lhn-hub/stm32-smart-environment-monitor/Docs/M3-acceptance.md

# M3传感器驱动与DataHub交付

2026-10-11最新DHT修订：初始化预配置EXTI12、接收使能后显式释放PB12开漏，增加失败电平/IRQ诊断；复测见M3-dht11-fix.md。当前普通固件合入此前M4/Flash修复，Flash54164B/RAM19488B，0错误0警告，实板DHT成功率仍待验证。

超声波修订已获用户确认：PA15=TRIG、PB3=ECHO（EXTI3优先级5），不再使用PA15回波输入。请按M3-ultrasonic-root-cause.md的烧录/复测步骤执行。该次历史构建Flash45484B/RAM16960B；后文最初构建数字为历史基线。

构建日期：2026-10-06。最终Code=40040、RO=3912、RW=112、ZI=16704；Flash44064B、RAM16816B，相比v0.3的39464B/15832B分别增加4600B/984B。距60KB Flash上限剩17376B，距20KB RAM剩3664B；11KB RTOS堆已包含在RAM中，任务栈不重复相加。

## 本次状态
按用户授权，采用M3-defaults.md中的资料默认值，不再要求填写标定作业单。代码、Keil构建及主机仿真完成后交付；没有运行实板50次温度采样或10/30/50cm测距，也没有以网上资料替代这些实验。
雷达为用户确认的Rd-03，EC11已取消，菜单继续PA0切换/PB15确认/PC13返回。MQ DO仍存在5V上拉冲突，正式构建`APP_MQ_DO_ENABLED=0`，需要保持DO与MCU断开。v0.4待硬件问题与验收完成，不提前打tag。

## 接线检查
- DHT11：PB12 DATA、3V3/GND，使用原通用IO3，核对供电/数据上拉均为3.3V；不要将模块高压上拉直接接入PB12。
- CS100A：PA15 TRIG、PB3 ECHO，保留原接口/供电；TIM4为1MHz/每ms回卷的HAL时基，测量使用完整bsp_micros时间戳。
- Rd-03：3V3/GND、OT2→PB5，高有效，3.3V电源需有≥200mA供电能力；PB4为蜂鸣器输出；OT1/RX不接USART3。
- MQ2/MQ135 DO：暂不接PB0/PB14；即使软件禁用也不会隔离实际5V，必须物理断开。日后启用必须先处理电平，不可直接将宏改1后接原5V DO。
- 电机仍不接；USB Device口不接。CH340串口115200、8N1、UTF-8。

## 改动文件与数据契约
- `Drivers_Device/sensor.h/.c`：6项固定注册表与sensor_ops_t；sensor_read读取统一缓存，sensor_ioctl获取诊断/修改气体确认时间，SensorTask用ops.read采集后再次通过sensor_read统一发布。
- `App/datahub.h/.c`：约192B的快照含各实例值、质量、时间戳、辅助值、辅助质量、flags及warmup_remaining_ms。互斥只包围内存复制，不在锁中等待硬件或打印。失败保持上次成功时间戳；快照超过各设备周期×3为STALE，已有FAULT不升级。
- `Drivers_Device/dht11/dht11.h/.c`：20ms开漏低电平启动（任务阻塞让出CPU），PB12/EXTI12有序脉宽捕获，82段响应/数据宽度、40bit解码与累加校验、温湿度×10整数，2100ms周期，5样本滑动均值。通信失败清空均值窗口，连续10次失败FAULT，恢复一帧后重新积累。
- `Drivers_Device/cs100a/cs100a.h/.c`：12us触发，PB3/EXTI3双沿ISR只取时间戳，任务等待30ms超时；5样本中值先作用在us再四舍五入为cm；累计不足5样本STALE，连续5次失败FAULT，成功后自动恢复并重新填中值窗口。
- `Drivers_Device/mq_gas/mq_gas.h/.c`：smoke/air两个实例，200ms扫描、低有效、300秒预热倒计时，预热期输出STALE且报警值0，辅助值保留原始DO。已通过主机模拟验证启用路径；正式固件安全门关闭，FAULT并带DISABLED标志，绝不显示正常空气。烟雾确认3秒、空气确认10秒，解除10秒；阈值菜单确认时间通过DataHub同步，仅RAM有效。
- `Drivers_Device/radar_rd03/radar_rd03.h/.c`：PB5高有效，确认/解除均1秒。开机前1秒为STALE，此后质量GOOD仅表示电平采样与消抖有效，不表示验证了设备在线。带NO_OPEN_WIRE_TEST标志。
- `Drivers_Device/mcu_internal/mcu_internal.h/.c`：M1温度函数/ADC快照注册到同一接口；温度继续FAULT，辅助VDDA为标称估算，保留原ADC采样时间；无新DMA采样超过1秒为STALE，ADC错误/零值FAULT。
- `Middleware/filter/sensor_filter.h/.c`：固定5样本中值/均值、带独立确认/解除时长的二态滤波器；整数，无动态大缓冲。
- `BSP/bsp_controls.c`、`Src/stm32f1xx_it.c`：EXTI3处理PB3超声；共享EXTI15_10先PB12 DHT，再PC13；没有EC11。DHT12仅在接收期间开启，完成后显式关闭IMR，因为F1 HAL_GPIO_Init(INPUT)不会自动关闭已有EXTI。
- `BSP/bsp_analog_rtc.c`：记录ADC DMA时间戳，提供任务原子快照。
- `App/tasks/app_tasks.c`：SensorTask枚举采样/发布/统一日志，原6栈和11KB heap不变；修正监控检查使用旧循环时间可能早于最新心跳而无符号下溢的问题。
- `App/menu/menu.c`：主页显示DHT温湿度、距离、雷达检测及MQ禁用/报警状态；FAULT显示文字而非虚构数值，STALE以标志显示。网络状态仍为后续阶段占位。

## DHT11时序与临界区裁决说明
已授权用资料默认值继续。完整DHT响应是3~5ms，原“整段关中断并且总共<2ms”不能同时满足；本实现无需整段屏蔽中断。
临界区仅用于捕获状态和GPIO/EXTI交接，TIM4优先级4不受BASEPRI遮蔽；ISR只记录当前电平和脉宽，不延时/打印/擦Flash。20ms起始与7ms捕获超时都用vTaskDelay等待，若起始低超过手册30ms则此次失败。
EXTI响应延迟和实际临界区时长需逻辑分析仪验证，代码结构不等于“实测<2ms”。现有全局中断优先级与看门狗保留。超声波触发12us为唯一短忙等，未在临界区执行。

## 串口示例及数值单位
下列仅为格式示例，不是实测：
```
[<tick>][采集任务][信息] 传感器 DHT11 值=260/GOOD 附=550/GOOD 时间=<ms> 标志=0x0 预热=0s
[<tick>][采集任务][信息] 传感器 CS100A 值=30/GOOD 附=-1/FAULT 时间=<ms> 标志=0x0 预热=0s
[<tick>][采集任务][信息] 传感器 MQ2 值=-1/FAULT 附=-1/FAULT 时间=<ms> 标志=0x7 预热=299s
[<tick>][采集任务][信息] 传感器 Rd-03 值=1/GOOD 附=-1/FAULT 时间=<ms> 标志=0x4 预热=0s
[<tick>][采集任务][信息] 采集统计 DHT=<成功>/<尝试> 连败=<次数> 超声失败=<累计> 连败=<次数> 发布失败=<次数>
```
- DHT：主值温度×10，附值湿度×10。CS100A：主值cm，辅助不使用。
- MQ：主值0未报警/1报警；辅助原始DO0/1；禁用时均-1/FAULT。flags1=预热、2=禁用、4=不支持开路诊断、8=估算。
- Rd-03：0无人/1检测到目标。MCU：主温度×10或FAULT；附值VDDA mV并有独立质量，flags8=估算。
- 成功率分子为通过解码校验的采样次数，初始无数据FAULT；不能通过重复打印缓存增加成功次数。

## DoD操作
1. **DHT11**：上电后记录连续50次尝试及成功计数差值，至少48次成功才达到≥95%；与相邻参考温度计在稳定环境对比，25℃条件标称温度±2℃、湿度±5%RH。均值有响应延迟，通信成功率与误差分开记录。
2. **超声波**：平面反射板分别在10/30/50cm放稳，等待至少5次成功读数；每点记录5个中值输出，误差≤±1cm。使用M3-calibration.md表格作为可选记录，不再要求上传回填。它是测试记录，不是驱动工作的前置门槛。
3. **MQ**：当前必须显示DISABLED/FAULT，不能验收酒精/呼气硬件翻转。未来安全电平接入后，等待300秒warmup消失，用DO刺激检查烟雾≥3s、空气≥10s确认和≥10s解除，不能把主机仿真当作硬件测试。
4. **雷达**：进入/离开探测区，OT2持续高/低1s后再切换；静止1分钟观察误触发。出厂雷达内部处理延迟还会叠加在软件1s之上，不能仅根据软件定义真实响应时间。
5. **拔线**：DHT连续10次、超声连续5次失败后FAULT，过程中其它任务心跳/屏幕继续运行，接回自动恢复。不短接电源。DO传感器拔线与合法高电平可能相同，无硬件额外信息就不能可靠判开路，本项目不伪造“所有DO拔线10周期FAULT”。
6. **统一接口**：启动后每5秒看到6个名称及相同质量/时间格式，通过注册表数量6及主机测试验证同一sensor_read；无数据的实例仍枚举但不假报成功测量。
7. **资源**：Docs/M3-build.log、M3-map.txt、M3-tests.log保存构建及主机结果。最终增量见交付回复，实际栈剩余仍按运行日志≥30%检查。

## 主机验证与边界
Docs/test_m3.py直接编译实际驱动与注册表：有效/错校验/异常脉宽、ISR时间戳模拟、超时后返回、10/30/50cm计算与中值、计时回绕、MQ安全门/预热/迟滞/参数修改、Rd-03消抖、MCU旧样本、失败质量与恢复、DataHub互斥失败。MQ启用仅在主机临时预处理覆盖，不改变正式配置。
旧菜单/按键与OLED恢复测试继续回归。全部测试不构成实板精度、成功率或真实热插拔证据。
本阶段没有改引脚以绕过电气冲突，没有关闭看门狗/超时/校验/互斥。MQ硬件接入和二值DO开路诊断无法仅靠固件解决，v0.4尚不创建。
