lhn-hub/stm32-smart-environment-monitor/Docs/M2-acceptance.md

# M2 OLED/EC11/菜单交付

## 用户功能验收确认（2026-10-05）
用户在PA0三键版本交付后回复“功能完整”，据此记录M2功能验收并发布v0.3。基线为ede5857：取消EC11，PA0切换、PB15确认、PC13返回。
编译记录0错误0警告，Flash39464B/RAM15832B。未提供的帧率实测值、插拔录像等不补造；下方历史待验收描述保留为操作参考。工作区未提交的Keil本地保存状态不自动纳入发布。

## 最新方案：三键菜单（替换EC11交互验收）
用户明确取消EC11，使用核心板KEY1=PA0切换菜单。EC11驱动文件仅保留历史源码，已从Keil构建及ISR回调移除；PA11/12改普通输入，USB Device仍禁用。断电拆除EC11，无需新模块。
- PA0单击：主页进入菜单；列表下一项，末项回到首项；阈值编辑时+1。
- PA0长按1.5s：列表上一项，首项回到末项；阈值编辑时-1。
- PB15单击：进入/确认、切换阈值编辑状态。编辑中长按PB15：3秒内增减步进10。
- PC13：返回上一级；Font test先退到Manual Test。
原“旋转20格”验收被用户新方案替代；请改测PA0短按/长按各5次、列表首尾循环、4项阈值增减与限幅、PB15确认和PC13返回。OLED恢复/清晰度/帧率要求保持。
主机三键菜单导航/增减/加速/限幅测试通过，编译0错误0警告。Flash39464B，RAM15832B；实板按键操作待用户验证，未打v0.3。

## 显示清晰度/编码器诊断更新
用户反馈OLED不清晰、EC11接原方案仍无正常操作。已将ASCII替换为专用Adafruit classic5x7点阵加空列(6x8)，8x16使用整数倍纵向扩展；7个中文保留。许可随字模保存。主机预览已检查，真实屏幕清晰度待新版烧录后反馈，若仍有错位/花屏需照片以核对控制器及屏幕规格。
EC11没有擅改引脚或每格边沿数，新增5秒诊断：`编码器诊断：AB=3 中断=80 非法跳变=0`。AB是二位编码：3=两路高，2=A高B低，1=A低B高，0=两路低。慢转时中断次数应增加；累计步数仅在菜单选择或阈值编辑时产生可见操作，主页旋钮不会切页，先PB15进入菜单。
实物检查：A→PA12、B→PA11、公共端C→GND（先确认裸编码器公共端，不把模块VCC误接地）；USB Device口禁接。先记录静止与连续20格后的两组“显示/编码器诊断”日志。中断不变时检查接触与线路；非法跳变多时再查抖动/漏边沿；只出现一半计数时核对实物每格边沿，不直接改变4边沿参数。
本次0错误0警告，Flash40432B/RAM15936B；原OLED恢复、菜单和编码器主机测试通过，EC11实物故障仍未定位。

## 状态与约定
基于v0.2，用户同意按本条页面和默认4阈值实现，不依赖未提供的计划书4.4。
软件/主机验证与物理DoD分开；20格实测、插拔恢复、无闪烁、实际10fps未完成前不打v0.3。
默认温度阈值50℃、入侵距离100cm、烟雾确认3000ms、空气确认10000ms，按格步进1，范围0~100/500/60000/60000。只在RAM保存，复位恢复默认；不会在M2驱动真实报警。

## 手工接线
断电插OLED到原接口：PB6=SCL、PB7=SDA，核对模块供电，地址0x3C。
EC11：PA12=A、PA11=B、3V3/GND，SW不接；PB15确认、PC13返回；USB Device口禁止插线。
保留CH340 115200 UTF-8和SWD，电机/业务传感器保持断开。
I2C启动扫描在SensorTask完成后才交给MenuTask，之后恢复/手动扫描由MenuTask独占，避免同时重配总线。不要从其它任务调用I2C。

## 文件与关键实现
- Drivers_Device/oled_ssd1306/ssd1306.h/.c：静态1024B显存，分页/脏页刷新，32B分块有界发送，失败500ms重试并调用M1九脉冲恢复；裁剪点/线/矩形/反白。
- fonts.h：95个ASCII字符的6x8与8x16表，7个16x16中文“报警布防撤故障”。离线将Windows本机Consolas/SimSun光栅化，不在MCU加载字体文件。Font test页用于实屏检查。
- Drivers_Device/ec11/ec11.h/.c：ISR只采样AB快照、写64槽静态环并发任务通知，任务执行4态转移；满4个合法边沿一格，往返抖动抵消，非法双位跳变重置部分格；溢出计数可见，不声称能补回漏边沿。
- Drivers_Device/oled_ui/oled_ui.h/.c：高亮行、进度条、状态符号；W/M/A/!/P依次表示WiFi/MQTT/布防/报警/预热，反白表示有效，下划线表示无效。网络/报警是未实现占位，预热按150秒计时。
- App/menu/menu.h/.c：enter/exit/render/on_key表、主页→菜单→子页三层栈，阈值RAM编辑。PB15单击进入/确认；长按在编辑时启用3秒10倍步进；PC13返回。显示帧周期80ms，不向OLED发送中间空白帧。
- App/tasks/app_tasks.c、BSP/bsp_controls.c：MenuTask消费编码器与统一键事件，维持原6任务栈/优先级/心跳。

## 操作与DoD
1. **编码器20格**：待主页出现，记录串口“编码器”累计数，连续同方向缓慢转20个机械卡点，差值应为+20或-20，丢失=0；反向20格应回原值。再在每秒约5格速度复测，包含轻微回抖。方向正负由实物A/B相位决定，不能把“20格只计10”归为通过；若每卡点只有2边沿或方向与预期不同，报告实测，不擅自改接线/系数。
2. **菜单可达**：PB15进MENU，依次旋转选择Home/Arm/Thresholds/Manual Test/Network/Event Log/System/About，每个子页PC13回MENU，再PC13回主页。选项超过5行会滚动，高亮保持可见。Arm仅切换RAM布防状态。
3. **阈值编辑**：Thresholds选择项目，PB15进入编辑，旋转一格数值±1，底部进度条变化；长按PB15后3秒内步进±10；再单击退出编辑。PC13返回，不保存到Flash。边界限幅，不能越界回绕。
4. **手动测试**：Manual Test含蜂鸣、红/绿/蓝/关、I2C Scan、舵机/风扇占位、Font test。占位不会启动电机或舵机；Font test显示双ASCII字模与7个中文，PC13退出。RGB仍使用已确认低有效语义。
5. **插拔恢复**：仅在确认模块支持热插拔的条件下，按用户DoD在板不断电时断开/接回OLED；否则断电换接不能证明自动恢复。未连接时心跳持续、失败计数增加；接回后无需复位恢复完整画面，System中fail=0；rec为累计恢复尝试次数，故意不归零，避免抹掉历史诊断。严禁短接电源针脚。
6. **帧率/闪烁**：每5秒串口输出`显示：帧率x10=<值> 耗时=<微秒> 编码器=<累计> 丢失=<次数> 连败=<次数> 恢复=<次数>`。帧率x10≥100代表平均≥10fps；耗时由TIM4 bsp_micros实测覆盖当次发送。观察主页/滚动/数字编辑无可见周期性清屏闪烁。正常全屏I2C理论约25~30ms不等于板上测量，不能填成实测成绩。断线期间帧率为0属预期，重连后至少一个完整统计窗再验收。
7. **System**：显示内部温度FAULT/校准OFF、VDDA标称估计、当前MenuTask栈剩余、I2C失败/恢复计数、刷新耗时、版本；温度FAULT沿用之前裁决，不能改为虚构温度。主页温湿度/烟气/距离/有人状态均明确占位，UTC来自RTC计数，未校时不代表真实时间。

## 软件验证
`Docs/test_m2.py` 编译实际EC11解码函数、完整SSD1306实现和实际菜单，模拟HAL边界：+20/-20、抖动/非法转移、脏页/无修改零传输、断线/重连、所有页面可达/返回、编辑加速/限幅、蜂鸣/RGB调用，渲染所有页面到tmp/m2/preview.png供视觉检查。
这些是主机测试，不替代真实机械旋钮、I2C电气或刷新观感。调用图已知worker最大深度约296B，不代替实际高水位；M2仍需确认MenuTask栈剩余≥30%。
全量Keil构建0错误0警告，日志Docs/M2-build.log，map Docs/M2-map.txt。Flash40284B/RAM15928B；v0.2为31628B/14576B，增量8656B/1352B。距60KB Flash红线余21156B、20KB RAM余4552B；RTOS11KB heap包含在RAM统计中，不重复加任务栈。

## 遗留与里程碑
v0.3待用户实板确认后创建。没有自动伪造插拔、帧率、20格或屏幕截图证据；主机预览会明确标为模拟。MenuTask拥有I2C的前提应在后续多客户端阶段改为统一总线仲裁，不可绕过。
