lhn-hub/stm32-smart-environment-monitor/Docs/M3-defaults.md

# M3资料默认配置（无需标定表回填）

2026-10-07更正：新模块资料与用户确认将超声波管脚改为PA15触发/PB3回波（EXTI3），保留12us触发、30ms应用超时、100ms周期。原PB3触发/PA15回波方案不再有效。参见M3-ultrasonic-root-cause.md。

更新2026-10-06：M3驱动/注册表/DataHub已完成软件实现与主机验证，交付以M3-acceptance.md为准；本文末尾“仍是后续工作”为旧状态。DHT接收采用PB12/EXTI12时间戳，不整帧关中断；MQ仍禁用等待安全电平方案。

2026-10-05用户授权：不再回填标定作业单，自行查询公开资料并采用默认设置。以对应型号厂家资料优先，GitHub示例交叉核对；没有统计多数用户设置，不能把个别示例当成普遍实测结论。

## 已写入bsp_pin.h的配置
| 项目 | 默认值 | 依据 |
|---|---|---|
| 雷达 | Rd-03，OT2→PB5，高有效 | 用户确认型号；规格书V1.1.1第9页；PB4留给蜂鸣器 |
| 雷达配置串口 | 115200bps | 规格书/协议与bertrik公开示例一致；仅外部USB-TTL，不占USART3 |
| 雷达消抖 | 1000ms | 原M3需求，非社区实测参数 |
| 雷达内部灵敏度/无人延时 | 保留出厂设置，不下发修改命令 | 无当前固件与环境信息，不复制其它场景灵敏度 |
| DHT11起始低电平 | 20ms | 手册允许18~30ms，Adafruit采用20ms |
| DHT11采样周期 | 2100ms | 手册要求>2秒，较常见2秒最小值留余量 |
| DHT11连续失败 | 10次FAULT | 原M3需求 |
| 超声波 | 12us触发、30ms超时、5样本中值 | 原M3需求，不冒充已找到CS100A实测；保留完整微秒时间戳 |
| MQ正常/报警 | 高/低；200ms扫描 | 野火两模块手册与原M3需求 |
| MQ启动预热 | 300秒 | 野火模块手册建议≥5分钟；取代原150秒 |
| MQ报警确认 | 烟雾3000ms、空气10000ms | 项目原默认值，不是浓度标定 |
| 报警解除 | 10000ms | 项目原默认值，后续驱动复用 |

## 在线核查来源
- https://github.com/adafruit/DHT-sensor-library/blob/master/DHT.cpp ：MIN_INTERVAL=2000，DHT11起始delay(20)，有有界脉冲等待，但InterruptLock覆盖接收段；不能照搬到“总屏蔽<2ms”的STM32/FreeRTOS约束。
- https://github.com/bertrik/aithinker-rd03/blob/master/aithinker-rd03.ino ：RADAR_BAUD_RATE=115200，与所附厂家协议一致。ESP8266管脚/SoftwareSerial不移植到本项目。
- https://github.com/Gjorgjevikj/Ai-Thinker-RD-03 ：其README明确开发中、基于厂家资料，不以该库证明量产可靠性或最佳灵敏度。
- 用户提供的野火MQ2/MQ135规格手册20250920版、DHT11 V1.3_20170331、Rd-03规格书V1.1.1；原始成员位置及SHA256见M3-source-review.md。
在线查询只获取公开文本，不运行第三方代码，不安装依赖、不刷模块固件。

## 不再等待回填，但不能伪装成立的条件
- MQ DO经10k上拉5V，PB0不可承受这种默认接法。保持MQ DO与MCU断开，后续软件将该通道作为未接入/FAULT而非正常安全状态；不自动增加模块、更改引脚或降低5V加热电压。
- 需要接入MQ时必须解决硬件电平。不能仅把GPIO配置成输入就获得5V保护，也不能凭社区接线替代电气条件。没有实施硬件修改。
- 电位器无可复制的圈数/位置；保留出厂位置仅能作未校准参考，不能声称酒精/呼气对应准确浓度或某固定触发点。
- DHT11后续实现不整帧关中断：20ms起始交任务等待，响应接收有界判时/校验，保留TIM4中断；失败计数与质量状态如实输出。成功率不能从网上推断。
- MQ/雷达单DO无独立开路反馈；DO可读只说明逻辑电平，不证明设备在线。原“所有传感器拔线10周期FAULT”在现有二值接线不能普遍成立，不伪造诊断。
- 内部温度仍保持校准禁用/FAULT、VDDA标称估算。

## 本次交付边界
本次完成公开资料核查、默认宏配置和构建验证。sensor_ops、DataHub、DHT11/CS100A/MQ/Rd-03运行驱动仍是M3后续工作，未因此发布v0.4或宣称M3验收完成。现有运行固件仍为M2；300秒宏会同步影响主页预热图标。
