lhn-hub/stm32-smart-environment-monitor/Docs/M3-source-review.md

# M3用户压缩包资料核查

## 新增雷达包核查
已读取雷达模块.zip：内含安信可Rd-03规格书V1.1.1、Rd-03模组说明书、串口通讯协议v1.0.0和固件烧写指导、PC配置工具。没有运行EXE、没有烧写固件。
资料对应Rd-03（24~24.25GHz），并非原方案AT6010 60GHz，不能据此填写AT6010的M6/M7定义。
规格书第6页：供电3.0~3.6V、推荐3.3V，供电能力≥200mA；默认115200bps。
规格书第9页管脚定义（已视觉核对）：1=3V3，2=GND，3=OT1/UART_TX，4=RX/UART_RX，5=OT2，感应时高、未感应时低。串口协议第6页给出115200、1停止位、无奇偶校验。没有M6/M7引脚。
Rd-03 OT2现接PB5；PB4留给用户已接入的主动蜂鸣器，3V3/GND保持原供电，OT1/RX仅用于独立USB-TTL配置。
解包索引tmp/m3-radar/index.json；规格书副本tmp/m3-radar/4.pdf，协议6.pdf，说明书7.pdf。实物型号、电平及静止1分钟误触发仍待确认。

核查日期：2026-10-05。仅阅读资料与例程，未运行压缩包中的程序。

## 压缩包清单
- 野火小智DHT11温湿度传感器模块.zip，SHA256 `4cbf23905bab1f42b6f256914ba3c7d52828a4c53a9206f3659206bf68131e6c`
- 野火小智MQ135空气检测模块.zip，SHA256 `e16e7ff80c7c9d80e3636f01c7aaff15f79e1d3acb0d847818bedbe6d5c4233a`
- 野火小智MQ2烟雾检测模块.zip，SHA256 `f1b628ec4cf6cfecbd9860121dab829d187e5a362399d20a27e98d761c2c07b2`
- 野火小智TTL转RS485模块.zip，SHA256 `70bce426e7aec0fed8df6e627a164f01efe42c813b409ccad2e3a69919b013a9`

## 结论
- 已找到DHT11、MQ2、MQ135、TTL转RS485四包，未发现AT6010/60G雷达或CS100A压缩包。RS485包不是雷达定义资料，不接入方案外模块。
- MQ2原理图第3页、MQ135原理图第1页：LM393 1OUT/DO经R9=10k上拉至VDD_5V，无3.3V电平转换。DO高电平按该图应接近5V（实际需测）。与要求DO≤3.3V冲突，不能直接认定满足；PB0是非5V容忍的ADC复用脚，尤其不能据“任意GPIO”例程说明直接接入。
- 两模块规格手册20250920版：5V供电，浓度高于电位器阈值时DO低；建议预热不低于5分钟。附气敏元件手册标准测试预热不少于48小时，并按存储时间给出48/72/168小时老化建议；这些与每次启动150秒屏蔽不是同一个概念。
- 电位器翻转点及DO实测电压仍为空，不能从文件替代实物标定。
- DHT11数据手册V1.3_20170331：启动等待1秒，起始低18~30ms，响应低78~88us/高80~92us，每位低50~58us，0高23~27us，1高68~74us；高位先出40位+8bit累加校验，读取间隔>2秒。
- 40位低电平合计已至少2ms，再加高电平/响应，整帧接收必超过2ms，不能整帧屏蔽中断满足总关中断<2ms。
- DHT11标称温度±2℃、湿度±5%RH（25℃条件，详见手册条件），不能脱离条件声称全范围保证。
- 官方DHT11标准库例程存在无超时while等待，且并非FreeRTOS实现；只参考协议，不复制会导致断线死循环的做法。
- MQ例程包含AO/ADC及浮点ppm估算，与本项目DO-only不符，不能搬用ppm路径。

## 来源索引（解包副本位于tmp/m3-docs）
- `野火小智DHT11温湿度传感器模块.zip` → `野火小智DHT11温湿度传感器模块/1-硬件资料_参考资料_模块手册/原理图_尺寸图/野火小智DTH11模块原理图.pdf` → `tmp\m3-docs\野火小智DHT11温湿度传感器模块-5.pdf`
- `野火小智DHT11温湿度传感器模块.zip` → `野火小智DHT11温湿度传感器模块/1-硬件资料_参考资料_模块手册/原理图_尺寸图/野火小智DTH11模块尺寸.pdf` → `tmp\m3-docs\野火小智DHT11温湿度传感器模块-6.pdf`
- `野火小智DHT11温湿度传感器模块.zip` → `野火小智DHT11温湿度传感器模块/1-硬件资料_参考资料_模块手册/参考资料/DHT11数据手册.pdf` → `tmp\m3-docs\野火小智DHT11温湿度传感器模块-8.pdf`
- `野火小智DHT11温湿度传感器模块.zip` → `野火小智DHT11温湿度传感器模块/1-硬件资料_参考资料_模块手册/野火小智DHT11模块规格手册_20250920.pdf` → `tmp\m3-docs\野火小智DHT11温湿度传感器模块-9.pdf`
- `野火小智DHT11温湿度传感器模块.zip` → `野火小智DHT11温湿度传感器模块/2-配套例程_接线说明/野火小智DHT11模块例程说明_20240415.pdf` → `tmp\m3-docs\野火小智DHT11温湿度传感器模块-12.pdf`
- `野火小智DHT11温湿度传感器模块.zip` → `野火小智DHT11温湿度传感器模块/2-配套例程_接线说明/野火小智STM32F103C8核心板/标准库/串口显示温湿度/User/dht11/bsp_dht11.c` → `tmp\m3-docs\野火小智DHT11温湿度传感器模块-97.c`
- `野火小智DHT11温湿度传感器模块.zip` → `野火小智DHT11温湿度传感器模块/2-配套例程_接线说明/野火小智STM32F103C8核心板/标准库/串口显示温湿度/User/dht11/bsp_dht11.h` → `tmp\m3-docs\野火小智DHT11温湿度传感器模块-98.h`
- `野火小智MQ135空气检测模块.zip` → `野火小智MQ135空气检测模块/1-硬件资料_参考资料_模块手册/原理图_尺寸图/野火小智MQ135空气检测模块原理图.pdf` → `tmp\m3-docs\野火小智MQ135空气检测模块-4.pdf`
- `野火小智MQ135空气检测模块.zip` → `野火小智MQ135空气检测模块/1-硬件资料_参考资料_模块手册/原理图_尺寸图/野火小智MQ135空气检测模块尺寸.pdf` → `tmp\m3-docs\野火小智MQ135空气检测模块-5.pdf`
- `野火小智MQ135空气检测模块.zip` → `野火小智MQ135空气检测模块/1-硬件资料_参考资料_模块手册/参考资料/MQ135 XXW.pdf` → `tmp\m3-docs\野火小智MQ135空气检测模块-7.pdf`
- `野火小智MQ135空气检测模块.zip` → `野火小智MQ135空气检测模块/1-硬件资料_参考资料_模块手册/野火小智MQ135空气检测模块规格手册_20250920.pdf` → `tmp\m3-docs\野火小智MQ135空气检测模块-9.pdf`
- `野火小智MQ135空气检测模块.zip` → `野火小智MQ135空气检测模块/2-配套程序_接线说明/野火小智MQ135空气检测模块例程说明_20240506.pdf` → `tmp\m3-docs\野火小智MQ135空气检测模块-12.pdf`
- `野火小智MQ135空气检测模块.zip` → `野火小智MQ135空气检测模块/2-配套程序_接线说明/野火小智STM32F103C8核心板/标准库/User/mq135/bsp_mq135.c` → `tmp\m3-docs\野火小智MQ135空气检测模块-93.c`
- `野火小智MQ135空气检测模块.zip` → `野火小智MQ135空气检测模块/2-配套程序_接线说明/野火小智STM32F103C8核心板/标准库/User/mq135/bsp_mq135.h` → `tmp\m3-docs\野火小智MQ135空气检测模块-94.h`
- `野火小智MQ2烟雾检测模块.zip` → `野火小智MQ2烟雾检测模块/1-硬件资料_参考资料_模块手册/原理图_尺寸图/野火小智MQ2烟雾检测模块原理图.pdf` → `tmp\m3-docs\野火小智MQ2烟雾检测模块-4.pdf`
- `野火小智MQ2烟雾检测模块.zip` → `野火小智MQ2烟雾检测模块/1-硬件资料_参考资料_模块手册/原理图_尺寸图/野火小智MQ2烟雾检测模块尺寸.pdf` → `tmp\m3-docs\野火小智MQ2烟雾检测模块-5.pdf`
- `野火小智MQ2烟雾检测模块.zip` → `野火小智MQ2烟雾检测模块/1-硬件资料_参考资料_模块手册/参考资料/MQ-2 XXW.pdf` → `tmp\m3-docs\野火小智MQ2烟雾检测模块-7.pdf`
- `野火小智MQ2烟雾检测模块.zip` → `野火小智MQ2烟雾检测模块/1-硬件资料_参考资料_模块手册/野火小智MQ2烟雾检测模块规格手册_20250920.pdf` → `tmp\m3-docs\野火小智MQ2烟雾检测模块-9.pdf`
- `野火小智MQ2烟雾检测模块.zip` → `野火小智MQ2烟雾检测模块/2-配套程序_接线说明/野火小智MQ2烟雾检测模块例程说明_20240508.pdf` → `tmp\m3-docs\野火小智MQ2烟雾检测模块-12.pdf`
- `野火小智MQ2烟雾检测模块.zip` → `野火小智MQ2烟雾检测模块/2-配套程序_接线说明/野火小智STM32F103C8核心板/标准库/User/mq2/bsp_mq2.c` → `tmp\m3-docs\野火小智MQ2烟雾检测模块-93.c`
- `野火小智MQ2烟雾检测模块.zip` → `野火小智MQ2烟雾检测模块/2-配套程序_接线说明/野火小智STM32F103C8核心板/标准库/User/mq2/bsp_mq2.h` → `tmp\m3-docs\野火小智MQ2烟雾检测模块-94.h`
- `野火小智TTL转RS485模块.zip` → `野火小智TTL转RS485模块/1-硬件资料-模块手册_参考资料/原理图_尺寸图/野火小智TTL转RS485模块原理图.pdf` → `tmp\m3-docs\野火小智TTL转RS485模块-4.pdf`
- `野火小智TTL转RS485模块.zip` → `野火小智TTL转RS485模块/1-硬件资料-模块手册_参考资料/原理图_尺寸图/野火小智TTL转RS485模块尺寸.pdf` → `tmp\m3-docs\野火小智TTL转RS485模块-5.pdf`
- `野火小智TTL转RS485模块.zip` → `野火小智TTL转RS485模块/1-硬件资料-模块手册_参考资料/参考资料/芯力特_SIT3088E-V1.8_cn.pdf` → `tmp\m3-docs\野火小智TTL转RS485模块-7.pdf`
- `野火小智TTL转RS485模块.zip` → `野火小智TTL转RS485模块/1-硬件资料-模块手册_参考资料/野火小智TTL转RS485模块规格手册_20240805.pdf` → `tmp\m3-docs\野火小智TTL转RS485模块-8.pdf`
- `野火小智TTL转RS485模块.zip` → `野火小智TTL转RS485模块/2-配套程序_接线说明/野火小智TTL转RS485模块例程说明_20240805.pdf` → `tmp\m3-docs\野火小智TTL转RS485模块-379.pdf`
