lhn-hub/stm32-smart-environment-monitor/Docs/M3-runtime-diagnosis.md

# M3上板日志诊断（2026-10-06）

2026-10-11最新DHT无响应修订：0/26且捕获0段的实板现象仍需复测；已用GPIO握手模型复现并修复先释放后配置/清PR的丢沿缺陷，新增失败电平与IRQ计数。详见M3-dht11-fix.md；下方为历史日志与诊断，不将旧成功率当作新版本验收。

后续根因已确认并修正（2026-10-07）：官方模块ECHO实际接PB3、TRIG实际接PA15，原固件反向映射使过去脉宽不能当作可靠测距。用户确认后已改为EXTI3接收，见M3-ultrasonic-root-cause.md；本页下方为修复前日志及分析。

## 第二次诊断结果与修订（2026-10-06历史记录）
原始用户日志已保存为M3-board-log-20261006.txt。日志区间约50~81秒：
- DHT23/24→37/38，末次97.37%；新增14次尝试均成功，所有捕获失败分类为0。末次24.9℃/36.3%RH。尚不足连续50次精度/成功率验收；不能与上一次重启的13/24拼成同一次测试。
- 已确认注册表在HAL tick未满1000ms时也调用DHT read；驱动直接返回-1，不经过诊断计数，与“恰少1次且诊断全0”相符。修复：首次采样due不早于DHT11_POWERUP_MS，等待期不增加attempts/failures。没有删除真实失败计数、放宽协议或修改采样周期。
- 超声出现过107cm、最后有效timestamp=42804ms，随后上升/下降各50不再增加，最近失败1/ECHO=1/等待1~2us。已定位为**触发前输入高，未发新TRIG**。107是带FAULT的历史值，不是有效当前距离。尚不能判断模块持续输出高、接触/供电问题或MCU读入异常；本次未改超声协议、未强制驱动ECHO、未伪造恢复。需整板完全断电后复测；不靠无限重新触发绕过输入高检查。
- OLED状态1、ErrorCode0x20=HAL_I2C_ERROR_TIMEOUT，最近失败传输约30ms，恢复3→6；不是0x04无应答。相同优先级任务与更高优先级的同步UART日志会抢占I2C polling线程，8ms总传输预算包含这段CPU等待；代码路径上存在已确认的调度风险，但当前日志没有CPU调度跟踪，不能断言它是全部I2C错误的唯一原因。

### OLED最小修订
复用现有console priority-inheritance互斥锁，每个I2C命令/32B数据块前短暂取得，传输结束立即释放。更高优先级日志等待时通过优先级继承让该块完成；没有新建锁、改6任务优先级、屏蔽中断、暂停调度或增大8ms传输超时。
取得console锁的等待仍有APP_LOG_LOCK_MS=50ms上限；等不到时返回OLED_DEFERRED(-2)，保留脏页，不清空屏幕、不误判掉线、不计为成功帧；下个帧周期从页首重发。console锁不是I2C多客户端互斥，不改变原单任务I2C所有权；锁内不能调用LOG/printf。
此修改避免了同步日志进入块内的可重现模型风险，物理总线问题仍可能存在。GPIO、采集参数、MQ禁用与看门狗保护全部保留。

### 本轮验证
- TDD先验证初始DHT等待期间attempts应保持0，旧代码断言失败；新代码在0/999ms不读、1000ms开始成功。
- 主机模拟块内30ms同步打印导致I2C超时，旧OLED代码失败；加console互斥后通过。覆盖console繁忙延后、成功/错误释放、脏页重发、GPIO协议与所有原菜单测试。该30ms为模拟故障注入，不能标成实际波形测量。
- 编译实际console锁函数验证无锁/调度未起/ISR/PRIMASK/BASEPRI拒绝、等待上限及释放。
- 全量Keil0错误0警告。Flash45452B/RAM16960B；比上一诊断版45268B/16960B增加184B/0B。v0.4不提前发布。

### 下次操作
1. 重新打开工程、Rebuild并烧录。整板所有供电都断开后重新上电，超声对准30cm平整目标。
2. 看超声ECHO能否回0，上升/下降计数是否继续增加，距离时间戳是否更新。若仍长期ECHO1，请提供模块正反面丝印照片；保持PA15输入，禁止用GPIO强拉ECHO。
3. 观察OLED累计恢复是否停止增加；“最近错误”保留旧记录，不代表每次打印又失败。连败=0且恢复计数不再增加才说明这段观察期稳定。
4. DHT完成50次新尝试后再比较成功率，不再计入上电等待；所有实测数据仍需真实运行，未自动宣称通过。

以下为第一次诊断的历史记录：

## 用户反馈与已确认事实
- 用户提供40~50秒日志；确认CS100A已经插在扩展板原超声波接口。
- DHT成功计数8/19→11/22→13/24，末次累计54.2%，未达到50次≥95%。GOOD是最近一次值质量，不代表整个采集过程成功率合格；末次温度27.3℃、湿度29.8%RH。
- CS100A值=-1/FAULT、timestamp=0，失败391→488，说明尚无一次通过校验的回波。
- MQ两通道flags0x7=预热+禁用+无开路自检，按当前电平安全门属预期，预热结束仍禁用；不要直连5V DO。
- Rd-03值1表示检测到目标，单段日志不能证明有人/无人切换和静止误触发测试通过。
- MCU温度FAULT符合未校准策略；VDDA3535mV是标称VREFINT估算，超出3.20~3.40V目标，GOOD只表示数据新鲜，未证明电压正常或测量准确。
- 六任务栈余量55%~79%，堆余1120B，监控未锁故障；不能推断长期稳定性已达标。
- 显示帧率x10=113~117即11.3~11.7fps，刷新耗时约25.8~51.3ms；恢复次数增加说明I2C曾失败，原因尚未确认。
- 首部乱码后中文完整，可由接收起点/上电等原因产生，但未证实；没有根据这一片段改波特率/编码，也没有证据证明%g来自固件浮点格式。

## 本次改动：采证，不盲改接线/时序
原DHT所有失败均返回-1，没有记录失败阶段；超声也将预先高、缺边沿、脉宽超限混在同一计数；OLED只累计失败。已分别增加任务上下文诊断，每5秒随现有统计打印，不在ISR打印。
保持引脚、阈值、超时、优先级、滤波、MQ安全门不变。尚未获得实物失败的根因证据，不宣称已修复成功率或超声波。

## 烧录后需要的输出
复位运行约30秒，提供一组“采集统计”“DHT诊断”“DHT失败数”“超声诊断”“OLED诊断”。无需填写标定表。
各驱动“最近失败”会保留到下一次失败，即使下一帧已成功也不清空；这是刻意保留故障证据，不代表该时刻仍失败。

### DHT
`DHT诊断 最近失败=<码> 拉低=<ms> 采集=<us> 段=<个数> 异常段=<索引>/<us>`
`DHT失败数 拉低超时=... 无响应=... 缺段=... 边沿=... 响应宽=... 位宽=... 校验=... 范围=...`

| 码 | 解释 |
|---|---|
| 0 | 没有记录失败 |
| 1 | 起始低电平超过30ms，需排查任务调度延迟 |
| 2 | 没有收到响应起始下降沿 |
| 3 | 接收宽度段不足82段 |
| 4 | 相邻捕获边沿间隔超过200us |
| 5 | 响应低/高宽度不在既定范围 |
| 6 | 数据位低/高宽度异常，索引与宽度可用于追查丢沿/延迟 |
| 7 | 40bit收齐但校验和错误 |
| 8 | 温湿度范围/小数编码不合法 |

脉宽异常不能直接证明传感器坏；软件观测时间包含中断响应延迟。取得分类证据后再决定最小修复，不直接放宽脉宽判定。

### 超声
`超声诊断 最近失败=<码> 等待=<us> 脉宽=<us> 上升=<累计> 下降=<累计> ECHO=<当前电平>`

| 码 | 解释 |
|---|---|
| 0 | 没有记录失败 |
| 1 | 触发前ECHO已高，本次未触发 |
| 2 | 短触发延时返回错误 |
| 3 | 30ms内没有有效上升沿 |
| 4 | 有上升沿但没有下降沿 |
| 5 | 完成回波已超过30ms截止时间 |
| 6 | 回波宽度不在既定范围 |

上升/下降是PA15回调累计数，ECHO是打印时电平，不能当作示波器波形。接口资料已核对扩展板第14页GND/B3/A15/3V3，仍按原PB3触发/PA15回波处理，不擅自交换引脚。

### OLED
`OLED诊断 最近状态=<HAL状态> 错误码=<位图> 失败传输=<us>`
HAL状态1=ERROR、2=BUSY、3=TIMEOUT；错误位图0x04=AF（应答失败），其余以当前HAL头文件为准。记录的是最近失败的一次命令/数据块传输耗时，成功后不抹掉。恢复失败但没有新I2C传输时，仍为上次传输记录。
保持每次传输8ms上限和500ms重试，不通过扩大超时掩盖总线问题。

## 验证
使用TDD方式先添加诊断行为测试，观察未实现诊断时失败，再实现并复跑：起始拉低超时、缺响应、位宽/响应宽/边沿超限/错校验；超声预先高/触发失败/无上升/无下降/迟到/宽度异常；OLED保存HAL错误码、耗时且恢复后保留。
原协议、超时、回绕、滤波、DataHub及菜单测试继续通过。无实物修复通过声明。
完整Keil重编译0错误0警告，Flash45268B/RAM16960B，比上版增加1204B/144B。任务已知调用图最大深度未增加（304B，间接调用与实际异常开销仍需运行高水位检查）。
