lhn-hub/stm32-smart-environment-monitor/Docs/M4-acceptance.md

# M4掉电存储交付与实板验收

2026-10-07。用户明确要求继续M4；M3尚未完成的MQ/传感器精度实物验收不被视为已通过，也没有补造v0.4。M4软件构建/主机断电仿真完成，v0.5待真实验收。

## 2026-10-11 Flash KV 启动修复

启动日志的 `KV扫描结果=-1 序号=2` 与扫描发现合法记录后 SPI 读失败一致。现有低优先级 LogTask 的 HAL polling 接收以墙钟计算 10ms 超时，可被更高优先级 OLED/同步 UART 抢占超过该窗口。实际 KV/W25Q/仲裁器件模型在 Bank B 第二槽接收时注入 40ms 抢占，旧驱动复现 `-1/seq2`，修复后扫描成功且保留 seq2。

修复仅在单次 HAL SPI 发送/接收内暂停任务切换；中断及 TIM4 毫秒时基保持运行，BUSY 轮询仍每 2ms 让出任务。原有 SPI 超时、擦写上限、页边界、CRC、commit 和错误后离线保留不变，不增加堆对象、不擦除现场介质。正常 256B 的线速约 0.228ms，真实硬件故障时这一调度窗口可持续至原 10ms SPI 超时，需复测任务时序。

本轮验证：抢占回归、注入真实 HAL 超时的模型、500次保存与逐字节掉电恢复、OLED/菜单/传感器回归均通过；Keil V6.24 全量构建 0错误0警告。当前映像 Flash=54092B（包含112B RW初始化数据），RAM=19464B，均在60KB/20KB预算内。当前普通 HEX 为 `MDK-ARM/Objects/sms-hub.hex`，SHA256=`10558D9AD6800A51F0201E04148A83B76551C742DEBDEDF77924FEA82495064E`；构建及 map 单独保存为 `Docs/M4-kv-fix-build.log`/`Docs/M4-kv-fix-map.txt`，未覆盖先前 M4 记录。

未进行实物下载或掉电验收。先按下方接线检查烧录新 HEX，应出现“存储就绪”；再改温度51、等待“配置已保存”，复位检查51仍在。若新版本仍失败，应记录具体失败地址/HAL状态并检查供电与共享总线；不能仅凭本机模型排除现场电气问题。

### 用户实板复测追加

2026-10-11新附件8d5ac49f已确认：209ms JEDEC=EF4017，270ms KV扫描=0/seq2，784ms事件扫描=0，852ms存储就绪/最近事件1/擦除1；日志至60235ms未再出现存储故障。**启动失败问题已通过本次实板复测**，并且启动事件写入及读回链路成功。

该日志没有“配置已保存”或再次启动段，因此20次配置保存/复位保持、500次实板轮换及人工掉电仍未通过验收。下一步在Thresholds改温度51并确认，等待保存成功后复位检查读回值与seq。此处不创建v0.5，不将单次启动当作完整M4验收。

## 先做硬件检查
1. 断开全部电源，将W25Q64直插原SPI1接口，核对VCC2=3V3、GND和模块朝向。CS=PA4、CLK=PA5、DO/MISO=PA6、DI/MOSI=PA7。
2. TB6612和电机暂时拔除。M4先测Flash，不把软件互斥当成物理隔离；M5才验证驱动模块同时连接后的切换波形/A通道不驱动。
3. 保持SWD、CH340、OLED和M3传感器原已修正接线；上方USB Device口不接、MQ DO仍不接5V输出。
4. 正常供电→Keil Rebuild→下载/校验，CH340115200/8N1/UTF-8。不要带电插拔Flash。

## 最终布局与格式
此次沿用已确认的物理4KB扇区隔离，M4提示中的“各2KB”不再按同扇区旧方案实现。完整WiFi/MQTT配置无法放入旧128B记录，因此改512B定长槽；每个Bank8槽，不是32槽。

| 区域 | 地址范围 | 格式 |
|---|---|---|
| KV A | 0x000000~0x000FFF | 4KB独立扇区，8×512B |
| KV B | 0x001000~0x001FFF | 4KB独立扇区，8×512B |
| 预留 | 0x002000~0x002FFF | 本实现不读写 |
| 事件环 | 0x003000~0x012FFF | 16×4KB，32B/条，共2048物理槽 |

config_t固定512B，包含magic/version/seq、温度×10/距离/烟雾/空气/入侵确认/解除/遥测周期、模式、MQTT端口/keepalive、SSID/密码、MQTT主机/用户名/密码、device、保留零字节、CRC32、commit。字符串容量33/65/65/33/65/33字节，包含结尾零；默认字符串过长会编译失败。字段范围和版本经过验证。
介质采用当前STM32/主机一致的小端定长结构，版本1，编译断言验证大小及commit偏移。未来结构变更要升版本并设计迁移，不能直接重解释旧字节。
CRC32为标准反射CRC32，测试串123456789得到0xCBF43926；提交标记0x434F4D54在最后单独编程。记录只有在magic/版本/字段/CRC/commit全部正确时才有效。

## 文件与行为
- BSP/bus_arbiter.h/.c：现有SPI1共享引脚mutex，take配置PA4GPIO-CS、PA5/PA7 AF推挽、PA6输入；give先STBY=0，再禁SPI、PA5/PA7=0、风扇CCR4=0。禁止ISR/临界区/故障态take，拥有者才可give；保留NOJTAG。
- Drivers_Device/w25q64：模式0、9MHz由M0 SPI初始化复用。read/init/program/erase全部经过仲裁；JEDEC不匹配则禁用写入，不进入反复复位。检查WEL、WIP，页编程禁止跨页并要求擦空、逐块读回验证；扇区擦除后读回全扇区检查。SPI接收dummy明确发送0xFF。没有删除超时或校验来强行成功。
- 擦除典型45ms只是参考；软件上限600ms、页编程20ms、初次忙状态800ms。轮询每2ms vTaskDelay，不阻塞其它任务；只由Monitor按原心跳表喂狗。600ms低于标称4s看门狗且低于1s业务心跳窗口，但完整API时长受调度影响，需实板高水位/心跳复测，不能用典型45ms替代实测。
- Drivers_Device/kvstore：每次提交在与最新有效记录相反的Bank顺序追加，满了才擦该目标Bank，另一扇区保留最新值。正常重启扫描16槽选最新；seq回绕用有界序列比较。新/第一次写入中断的介质在空槽初始化两份默认值；若任一Bank无尾部空槽且无有效记录，则保留现场并报错，不自动抹掉未知数据。
- Drivers_Device/eventlog：按物理槽前进，跳过不完整编程槽；下一扇区首次使用前擦除，禁止擦含最新有效记录的扇区。启动扫描2048槽重建头部位置/序号，读取时由最新向前遍历；**没有额外高频头尾指针扇区**，从CRC有效数据重建，避免元数据扇区先磨损。覆盖按16扇区轮转。log_read_last(n)返回最新在前，跳过CRC/提交失败记录。
- App/storage：LogTask是唯一Flash/KV/log写者，4条有界请求队列，缓存最近20条供菜单读取；缓存/字段读锁只包围内存复制，硬件访问不在UI锁内。队列满/离线/上次配置未完成会返回错误，丢弃计数可诊断，不能静默说已保存。
- 菜单：PB15进入编辑，PA0短按增/长按减，PB15再次确认排队保存；PC13直接返回取消未提交编辑。只有KV提交+读回成功才同步RAM字段与DataHub气体确认时长。Arm页面切换模式也通过KV。Flash失败显示STORE OFFLINE，不伪装保存成功。
- Event Log：PA0单击下一条、长按上一条，最多20条、5行滚动，PB15/PC13原导航不变；显示序号/类型/参数，底行Unix时间和第二参数。类型1=启动、2=配置提交、3=手动测试。每次启动追加启动事件，序号不会从1重新开始。
- System：`Erase boot`是本次启动成功擦除总次数，复位清零；`E`是本次存储错误。**没有实现全寿命掉电持久化擦除计数**，不能将该值宣称为累计寿命磨损数据。

## 基本串口预期
以下是格式示例，不是实物记录：
```
[<tick>][日志任务][信息] Flash JEDEC=0xEF4017 SPI=9MHz
[<tick>][日志任务][信息] 存储就绪 KV序号=<n> 最近事件=<n> 擦除=<n>
[<tick>][日志任务][信息] 配置已保存 序号=<n> 字段=0 值=51
```
字段0温度℃、1距离cm、2烟雾确认ms、3空气确认ms、4布防模式。密码不会打印到串口。
ID为0/FFFFFF/其它值时检查供电/跳帽/接触和方向，禁止跳过身份断言。存储故障后保留上一已确认UI/DataHub值，停止所有新写入，复位重新扫描；如果提交其实已落盘但应答/读回失败，重启可能读到新值，这是结果未知场景的正常保守处理。

## DoD①②：ID及20次复位保持
1. 按上面接线，看到EF4017和存储就绪，无存储故障。
2. 在Thresholds将温度改51，PB15确认，等待串口“配置已保存”；此时才算保存完成，SAVING消失。
3. 按复位或完全断电重启，应回读51且模式/其它字段不乱变。
4. 交替设置51/52，重复20次。记录写前seq、保存后的seq、复位读回值；20次均保持才能通过。取消编辑不应产生保存。
5. 进入Arm切换再复位验证模式保持；烟/空气确认时间提交后由DataHub热加载。其它阈值供后续报警引擎使用。

## DoD③：实际500次配置轮换
正常固件APP_STORAGE_STRESS_ENABLED=0。专用测试时改1→Rebuild→烧录；等存储就绪后，Keil Watch设置`storage_bench_request=1`，继续运行。
LogTask每轮最多保存一次，总计500次KV保存，最后一次恢复测试前温度值。其它配置不改；全过程仍执行Monitor心跳检查。开始后勿继续菜单改配置以免干扰记录。
等串口`存储压力测试结束 模式=1`，检查KV序号增加500、无存储故障、擦除计数增长；复位后读回恢复值。代码每次均readback+CRC验证，不以仅写成功判断。
该测试会消耗写擦寿命，但500次按8槽双Bank分摊；不要无休止循环。

## DoD④：手动断电20次
1. 先提交一个基准温度51并等待成功提示，记录为最后确认值。
2. 请求改52后立即切断**全部电源**，包括会给目标反供电的DAP/USB-TTL/USB/DC。仅按NRST不是断电。不要通过带电拔模块制造供电/信号乱序。
3. 重上电应正常启动，配置为51或完整提交的新值52，不能出现半新半旧/异常字符串/无法启动。保存提示发出前也可能已经提交；不能把合法新值误判为错误。
4. 20次分别选择提交后立即、稍晚及轮换擦除阶段（压力版观察擦除增长）。人工断电很难稳定命中微秒提交时刻，因此记录实际时刻/现象，不声称所有断电都命中写窗口。
5. 记录表：次数、旧值/seq、请求新值、断电点、重启值/seq、正常启动、备注。用户DoD≥19/20正常且恢复有效值；设计目标全部合法。任何一次损坏保留日志，不自动格式化掩盖问题。

## DoD⑤⑥：事件覆盖、重启及浏览
1. 多次保存配置和Manual Test操作，Event Log应显示递增序号，重启后保留历史且新增BOOT。
2. 用专用压力版将`storage_bench_request=2`，LogTask追加2304条测试事件，超过2048槽容量；旧扇区被轮换覆盖，最新20条保持可浏览。
3. 模式2测试会覆盖旧事件，属于环形验证。完成后查看最后20条序号相邻、参数对应最后几次测试；复位继续产生的新事件紧跟最后完整提交序号。
4. 环形覆盖中的断电只应损失本次未提交条目及已经被覆盖的最旧扇区，不能丢最新已提交记录。条目中的seq不能被解释为所有外部动作都有且只有一次：KV提交和追加CONFIG事件是两个事务，断电可能配置已存而其事件未写。
5. 压力测试后恢复APP_STORAGE_STRESS_ENABLED=0→Rebuild→烧回普通固件。当前交付ELF已恢复0且无storage_bench_request符号。

## 软件验证证据与资源
- Docs/test_flash_bus.py：编译实际总线仲裁和W25Q驱动，在SPI器件模型验证ID/WEL/页边界/扇区对齐/读回/超时、任意错误释放安全态、MISO不变输出、故障与ISR拒绝。
- Docs/test_storage.py：实际KV/eventlog和应用队列，500次提交且每次重启；针对KV4096+512字节、事件4096+32字节的每个位置中断擦除/写入/commit；测试第一次写入断电、满环部分擦除、2200事件覆盖、最新CRC损坏回退、seq回绕、队列满/离线/提交后才更新等。只模拟NOR逐字节变化，不涵盖所有真实棕断/供电波形/Flash内部失效模式。
- 原菜单/OLED与M3传感器回归通过，历史EC11单元测试仍存在但固件不链接编码器。
- 启动扫描同时建立每扇区有效记录数，运行时日志不足20条也不会每次重新读取空64KB；这些计数只在RAM缓存，重启从介质重建，不新增指针擦写热点。
- 普通固件Code49224/RO4328/RW112/ZI19352：Flash53664B、RAM19464B，较M3(45484/16960)增加8180B/2504B。Flash距60KB红线余7776B，RAM距20KB余1016B；RTOS11KB heap已算在RAM里，不重复加任务栈。
- 新请求队列/两个mutex需消耗原RTOS堆部分余量，实际启动heap_free/各任务栈≥30%仍需复测。链接调用图worker已知最大深度约472B，不替代运行测量。后续添加功能前必须重新预算。
- 压力版也已0错误0警告构建；普通版最终无测试变量。详见M4-build.log、M4-map.txt、M4-stress-build.log、M4-stress-map.txt、M4-tests.log。

## 待完成
真实JEDEC、20次保存/复位、500次硬件轮换、20次人工断电和环形覆盖尚未执行；M3遗留MQ5V问题不因进入M4而消失。尚未创建v0.5，也未将不存在的v0.4依赖伪装为已通过。System只有本次启动擦除统计，若必须跨断电持久化寿命计数，需要另行设计元数据和准确性边界。
