lhn-hub/stm32-smart-environment-monitor/Docs/M3-ultrasonic-root-cause.md

# 超声波根因：原方案TRIG/ECHO管脚反了

## 2026-10-07用户确认后已实施
用户回复“确认”，已将TRIG改PA15输出低、ECHO改PB3双沿EXTI3（优先级5）；移除PB3输出组与旧PA15中断输入。EXTI15_10继续处理PB12 DHT11和PC13，TIM2 RGB、TIM4计时与12us/30ms/100ms周期均不变。
已同步bsp_pin.h、gpio.c、stm32f1xx_it.c/.h、sms-hub.ioc、验收文档及测试。官方映射对照JSON保留修复前2项错误，并新增修复后2项匹配结果。
新测试独立固定官方PA15/PB3，不随业务宏改变预期；旧代码先断言失败，修复后通过。实际GPIO初始化验证PB3任何时候都不进入推挽输出、PA15启用输出前锁存低；实际IRQ/回调验证EXTI3只处理ECHO，DHT和PC13照常分流。ELF已确认含非弱EXTI3_Handler实现（实际符号EXTI3_IRQHandler）。原脉宽、超时、校验、菜单、控制和OLED回归均通过。
全量0错误0警告，Flash45484B/RAM16960B，相比修订前+32B/+0B；相对v0.3的39464B/15832B增加6020B/1128B。仍没有新固件上板测距通过声明，v0.4未打标。

### 烧录与复测
先断电拔下超声波模块，再给核心板供电烧录新固件，避免烧录前旧程序再次驱动模块ECHO。烧录校验完成后断开所有电源，将模块按原接口方向插回，再上电。不要反插模块，不需要交换杜邦线。
用足够大的平整目标分别测试10/30/50cm，每点稳定等待至少5次成功读数；应看到距离时间戳持续更新、连续失败保持0、上升/下降计数持续增长，中值窗口填满后quality=GOOD。任何不符如实记录，不能直接打v0.4。
超量程约33ms仍会按原30ms应用超时处理，未趁此次引脚修复扩大超时。MQ DO继续保持断开。

下方为发现根因时的历史证据；其中“当前错误配置/等待确认”仅描述修复前状态：

2026-10-07，针对用户提供的《野火小智超声波测距模块.zip》完成模块手册、模块原理图、官方F103C8 HAL例程与扩展板手册的交叉核查。没有运行包内程序，也没有改写硬件或固件。

## 已确认的映射错误

| 信号 | 原接口直插的正确MCU脚 | 当前错误配置 |
|---|---|---|
| TRIG，MCU输出 | PA15 | PB3 |
| ECHO，MCU输入 | PB3 | PA15 |

三份独立表示一致：
1. 模块规格手册20240510第5页表格/实物图：接口1=GND，2=ECHO，3=TRIG，4=VCC。
2. 扩展板V1.0.2手册第14页：对应接口GND、B3、A15、3V3，支持该模块直插。
3. 官方HAL/User/cs100a/bsp_cs100a.h：ECHO_GPIO=GPIOB、ECHO_GPIO_PIN=GPIO_PIN_3；TRIG_GPIO=GPIOA、TRIG_GPIO_PIN=GPIO_PIN_15。
模块原理图第3页J1也给出1=GND、2=ECHO、3=TRIG、4=VDD。

原文位置：
- 压缩包 `1-硬件资料_模块手册_参考资料/野火小智超声波测距模块规格手册_20240510.pdf`，提取副本 [9.pdf](../tmp/m3-ultra/9.pdf)。
- 同目录 `原理图_尺寸图/野火小智超声波测距模块原理图.pdf`，副本 [4.pdf](../tmp/m3-ultra/4.pdf)。
- 官方例程 `2-配套程序_接线说明/野火小智STM32F103C8核心板/HAL/User/cs100a/bsp_cs100a.h`，副本 [435.h](../tmp/m3-ultra/435.h)。
- 扩展板手册为工作区原始 `野火小智STM32F103C8T6扩展板_规格书V1.0.2.pdf`。
- 程序化对照及完整压缩包SHA256见同目录M3-ultrasonic-pin-audit.json，结果两项均不匹配；不是物理波形测量。

## 如何解释现象
在模块按原接口正确直插时，旧固件的PB3推挽输出实际接到了模块ECHO输出；PA15输入实际在读模块TRIG输入。存在输出争用以及未向正确TRIG脚发送触发的问题。
因此“输入持续高”“无上升沿”“偶发某个脉宽”均不能用原错误映射解释成正常回波。过去将107cm等数值称为有效测距不准确：它们只是通过软件范围检查的错误输入脉宽，真实距离未知。
此次确认为硬件映射和固件不一致；还不能证明每一次历史异常都由此唯一产生，也不能仅凭日志判断模块是否受损。应断开整板所有供电，暂停旧固件，修订后重新进行三距离测试。

## 可审阅的最小修订（等待用户确认后实施）
- 保留模块在原接口直插，不用杜邦线交换、不反插模块。
- bsp_pin.h：TRIG=GPIOA/PIN15，ECHO=GPIOB/PIN3。
- gpio.c：PA15输出默认低；PB3输入双沿EXTI，保持输入模式，不驱动模块输出。
- 增加EXTI3_IRQHandler、声明及NVIC抢占优先级5；EXTI15_10只保留DHT11(PB12)和PC13键处理，不能将ECHO回调放在不对应的IRQ。
- 保留NOJTAG/SWD、TIM4完整微秒时间戳、看门狗、超时、5点中值及质量状态。
- 不直接照搬官方TIM2捕获例程，因为本项目TIM2的CH2/3/4已用于RGB；EXTI3+现有微秒计时即可完成原协议。
- 更新IOC、接线文档和主机HAL测试，测试中的GPIO对象必须独立对照新管脚，不能只换一个宏后仍在GPIOA上模拟ECHO。

## 其它发现，非本轮首先调整项
- CS100A芯片手册V2.0第2/3页要求TRIG高电平>10us，通常建议约50us；当前12us名义值满足最低要求。优先修管脚，暂不同时调脉宽，以便确认根因。
- 芯片手册第4页及模块手册第5页说明无回波/超量程时ECHO约33ms；当前30ms应用超时会将它归为失败，这是超量程处理边界，不能解释近距离大部分无上升沿。100ms测量间隔已大于33ms。本轮不擅改已裁决的30ms。
- 官方CS100A_TRIG仅用两个NOP且注释称72MHz一个NOP是13.9微秒；实际上一个时钟周期约13.9纳秒，不能用该注释当作10us保证。继续采用现有实际计时延时，不移植错误注释。

## 状态
固件没有更改，没有新编译/烧录成功声明。遵循用户“唯一合法引脚、硬件不符先确认”的规定，等待同意将原错误管脚表改为PA15触发/PB3回波，再完成代码修正、编译与回归。v0.4仍未发布。
