lhn-hub/stm32-smart-environment-monitor/Docs/M3-calibration.md

# M3 硬件标定作业单

超声波当前唯一接法已按官方资料和用户确认更正：PA15→TRIG、PB3←ECHO，模块继续原接口直插；原先相反的描述作废。软件已修正EXTI3；测量记录表仍可用于后续复测。

最新裁决：用户不再回填，改用资料默认值。此表保留为可选未来测量记录，不再作为软件工作的必需输入。当前值与边界以M3-defaults.md为准；没有填写虚构实测数值。

状态：等待用户回填；依赖v0.3。未连接或未测项目填写“未测”，不推断通过。

资料已自行核查，详见M3-source-review.md：仅有DHT11、MQ2、MQ135和TTL转RS485包，缺雷达/CS100A资料。两MQ的DO均经R9=10k上拉5V，必须先断开MCU测量，不可填写为已满足≤3.3V；模块手册建议预热≥5分钟，原150秒参数尚未修改。DHT11手册读取间隔>2秒，亦与原精确2秒周期需协调。所有实测栏目仍等待用户测量。

## Rd-03（用户已确认替换AT6010）
最终GPIO接线：3V3→3.3V、GND→GND、OT2→PB5；蜂鸣器信号→PB4；供电能力≥200mA。OT2高有效，1秒软件消抖。OT1/RX平时不接；独立配置时使用3.3V逻辑USB-TTL，OT1→适配器RX，RX←适配器TX，共地，115200、1停止位、无校验。USART3仍留给ESP8266。资料定义已确认，电平/静止实测尚未提供。

| 项目 | 回填 |
|---|---|
| 模块完整型号/版本 | Rd-03（用户确认），硬件版本待填 |
| 官方例程链接或本地文件路径、版本 | |
| 例程接线及模式配置 | |
| UART波特率/数据位/校验/停止位 | |
| OT1定义 | UART_TX（资料） |
| OT2定义 | 检测输出，高有效（资料） |
| 无人时OT2电压/逻辑 | 待实测；资料为低 |
| 有人移动时OT2电压/逻辑 | 待实测；资料为高 |
| 有人静止1分钟时OT2电压/逻辑 | 待实测 |
| 离开后恢复时间/误触发次数 | |

## MQ2/MQ135
DO先与MCU断开，模块按原方案5V供电，万用表黑笔接模块GND。先按厂家要求预热/老化，记录实际时间；首次老化可能远长于项目的150秒启动屏蔽。
通风且无火源环境，少量酒精蒸气靠近MQ2，不接触液体、不喷洒热元件；呼气测试MQ135，不让冷凝水进入电路。它们仅用于比较器阈值功能测试，不构成ppm定量标定。
记录初始电位器位置，缓慢调整翻转点，记录移开刺激后的恢复，不猜顺/逆时针方向。任一DO高电平>3.3V，停止接MCU并报告，不自行改线。

| 项目 | MQ2 | MQ135 |
|---|---|---|
| 型号/版本 | | |
| 实际预热时间 | | |
| 正常空气DO电压 | | |
| 触发条件 | 酒精蒸气 | 呼气 |
| 触发后DO电压 | | |
| DO最高电压（必须≤3.3V） | | |
| 电位器翻转点是否稳定 | | |
| 移开后恢复时间 | | |

## 后续误差记录表
DHT11：记录参考温度计型号、精度、两者距离与稳定环境；50次连续读取记录成功/校验失败/超时、温湿度原值、参考读数，不能只挑成功样本。95%要求50次至少48次成功。

| 超声波基准距离 | 单次样本（至少5次，cm） | 中值(cm) | 中值误差(cm) | 是否≤±1cm |
|---|---|---|---|---|
| 10cm | | | | |
| 30cm | | | | |
| 50cm | | | | |

## 实现前待裁决约束
1. TIM4每1ms回卷，不能直接以两个CNT相减测量30ms Echo；继续使用bsp_micros()的32位时间戳差。M3明确30ms超时优先于旧38000us宏，实施时统一更新。
2. DHT11完整40位返回帧通常约3~5ms，不能整帧屏蔽中断又满足“总关中断<2ms”。现有bsp_delay_us禁止在BASEPRI/PRIMASK下调用，bsp_micros依赖TIM4中断；PRIMASK屏蔽TIM4可能导致读取循环不退出。推荐18ms用任务延时，数据段开中断、有界轮询和校验失败重试，先测50次成功率；如需更强抗抢占能力，再评估PB12边沿时间戳方案。不能未经实测声称微秒精度/成功率已满足。
3. MQ和GPIO模式雷达只有单根二值输出。断线时MCU上拉高与合法高电平可完全相同，无法保证“拔任意传感器10周期内FAULT”。不得通过长时间没有报警/无人误判故障。可确认通信失败的DHT11/超声波实施连续失败FAULT；DO通道必须明确无法独立诊断开路，或由用户另行授权硬件诊断方案。
4. 内部温度仍沿用已确认的校准未验证→FAULT，VDDA标称估算；注册为sensor不等于温度可用。

回填后先落实上述约束，再进入sensor接口、驱动最小测试、DataHub和SensorTask集成。不提前发布v0.4。
