lhn-hub/stm32-smart-environment-monitor/Docs/M3-dht11-fix.md

# DHT11无响应修复与复测（2026-10-11）

已修复总线释放与EXTI接收交接的时序缺陷，并完成主机回归及普通固件构建。尚未烧录或实板复测，不能宣称现场DHT0/26已经恢复。

## 资料与接线

- 用户ZIP中的《野火小智DTH11模块原理图》J4为3V3/GND/NC/DATA，DATA经10k上拉至3V3；扩展板规格书第12页IO3为3V3/GND/NC/PB12。带转接板模块直插IO3时当前PB12映射正确，未改成官方例程的PB0。
- 裸传感器脚序为VDD/DATA/NC/GND，与转接板J4不同，不能照转接板顺序直接接裸件。
- 奥松DHT11 V1.3_20170331手册表10：起始低18~30ms，释放后10~35us开始响应，上电等待1秒、读间隔>2秒。保留20ms任务等待、2100ms周期。
- 本地ST RM0008 Rev21第163页9.1.8：开漏ODR=1为高阻，输入缓冲和IDR采样仍有效；输出模式内部上下拉关闭。本修复接收期间使用模块原有外部10k上拉。

原始成员索引见`tmp/m3-docs/index.json`，提取PDF为`野火小智DHT11温湿度传感器模块-5/-8/-9/-12.pdf`；正确转码例程为`-97.c.txt`。未执行资料包内程序或照搬例程中的无限等待。

## 缺陷与修复

旧驱动在低脉冲结束后调用HAL配置上拉输入/双沿EXTI。当前F1 HAL先写ODR高释放总线，之后才更新GPIO、AFIO、触发器和IMR；驱动随后清PR，可能丢掉早响应下降沿。不是“忘记拉高”。

新驱动在初始化时配置PB12/双沿EXTI并屏蔽IMR；每次仍用开漏拉低，再在短临界区准备捕获、清旧PR、开启IMR、记录时间、显式ODR置高释放。接收期间不重配EXTI或清PR，结束后关闭DHT接收并恢复上拉输入。

82段完整性、脉宽范围、40bit累加校验、数据范围、7ms捕获截止、失败质量和看门狗均保留。没有整帧关中断、增加堆对象、修改TIM4时基或此前Flash驱动修复。

主机模型中13us响应/零配置延迟可以正常解码；旧驱动遇到10us响应及注入16us配置延迟时只收81段，返回INCOMPLETE；修复后通过。16us为故障注入，未实测板上配置耗时。现场最新日志是NO_RESPONSE/0段，此模型没有复现它，不能把软件缺陷认定为唯一现场原因。

## 烧录与观察

1. 使用`MDK-ARM/Objects/sms-hub.hex`烧录当前普通固件；构建记录为`M3-dht-fix-build.log`，0错误0警告。
2. 完全断电后检查模块正向接在IO3、3V3/GND/DATA对应，再重新上电。日志每5秒输出DHT统计，不需要反复复位。
3. 运行约2分钟，检查DHT成功计数、有效温湿度及时间戳是否增加。连续50次尝试至少48次成功才达到原≥95%要求，温湿度精度需另与参考仪表对比。
4. 若仍无响应，提供新日志的“采集统计”“DHT诊断”“DHT失败数”，用以下字段继续定位。

新诊断格式：

```text
DHT诊断 最近失败=<码> 拉低=<ms> 采集=<us> 段=<数> 异常段=<索引>/<us> 电平=<起始低末端>/<刚释放>/<捕获结束> IRQ=<接收回调数>
```

电平0/1为实际GPIO读数，2表示该阶段未执行。IRQ计数包括主机释放产生的上升沿，不等同于传感器响应数。诊断保留最近失败，即使后续成功也不清零；是否恢复看成功计数与时间戳。

| 最近失败为NO_RESPONSE时的观测 | 下一步 |
|---|---|
| 电平0/1/1，IRQ=1 | 起始低与释放高已读到，但未捕获传感器响应；核对供电、DATA连接、模块方向及上拉 |
| 电平0/0/0，IRQ=0 | 数据线到捕获结束仍低；测量DATA与3V3、排查持续拉低或上拉/连接问题 |
| 电平0/1/1，IRQ=0 | 读到释放高但无回调；进一步核查实际烧录版本、EXTI/AFIO/NVIC及PR，不直接判断模块坏 |
| 起始低末端为1 | 检查PB12是否真正拉低、连接或电气争用 |

“刚释放”是瞬时采样，RC上升或抢占可能影响读数，单独一个0不能证明短路；需结合结束电平、IRQ与真实波形。

## 验证记录

`test_dht_handshake.py`通过真实低脉冲/释放触发模型验证：早响应、10/13/35us响应边界、断线、持续低、IRQ阻塞、失败不改输出、重连恢复、超长起始恢复、最近失败证据保留、旧PR清理、其它EXTI位保留及微秒回绕。

原M3协议/解码/质量/滤波、实际GPIO/IRQ映射、OLED/菜单、Flash抢占/真实HAL超时注入、KV/事件逐字节掉电回归通过。模型不代替实板电压、波形、成功率与精度验收。

Keil Arm Compiler6.24：Code49408、RO4644、RW112、ZI19376；Flash54164B/RAM19488B，相比前一Flash修复版增加72B/24B，60KB/20KB预算余7276B/992B。map及反汇编确认预配EXTI与先使能后释放已链接，W25Q调度保护仍在，普通固件无压力/看门狗故障注入入口。

HEX SHA256：`2BE9A21D00F66D0DD3690BF67B98E28D555404D03F9C98E6BA0573A1F79B9956`。
