lhn-hub/stm32-smart-environment-monitor/App/app_config.h

#ifndef APP_CONFIG_H
#define APP_CONFIG_H
#include "bsp_pin.h"
#if defined(__has_include)
#if __has_include("app_secrets.h") && !defined(APP_NO_LOCAL_SECRETS)
#include "app_secrets.h"
#endif
#endif
#define APP_FW_VERSION "0.9.0-dev"
#ifndef APP_CRITICAL_AUDIT
#define APP_CRITICAL_AUDIT 0
#endif
#ifndef APP_WIFI_SSID
#define APP_WIFI_SSID ""
#endif
#ifndef APP_WIFI_PASSWORD
#define APP_WIFI_PASSWORD ""
#endif
#define APP_MQTT_HOST "broker.emqx.io"
#define APP_MQTT_PORT 1883u
#define APP_MQTT_TOPIC_ROOT "smshub/%s"
#define APP_MQTT_TOPIC_TELEMETRY APP_MQTT_TOPIC_ROOT "/telemetry"
#define APP_MQTT_TOPIC_EVENT APP_MQTT_TOPIC_ROOT "/event"
#define APP_MQTT_TOPIC_STATUS APP_MQTT_TOPIC_ROOT "/status"
#define APP_MQTT_TOPIC_CMD APP_MQTT_TOPIC_ROOT "/cmd"
#define APP_MQTT_TOPIC_RESPONSE APP_MQTT_TOPIC_ROOT "/cmd/resp"
#define APP_MQTT_LWT "offline"
#define APP_TELEMETRY_MS 2000u
#define APP_MQ_WARMUP_MS (MQ_WARMUP_S * 1000u)
/* Stack sizes are StackType_t words (4 bytes on Cortex-M3). */
#define APP_MONITOR_PRIORITY 5u
#define APP_MONITOR_STACK 192u
#define APP_ALARM_PRIORITY 4u
#define APP_ALARM_STACK 256u
#define APP_NET_PRIORITY 3u
#define APP_NET_STACK 512u
#define APP_SENSOR_PRIORITY 2u
#define APP_SENSOR_STACK 256u
#define APP_MENU_PRIORITY 2u
#define APP_MENU_STACK 384u
#define APP_LOG_PRIORITY 1u
#define APP_LOG_STACK 256u
/* Initial scheduling defaults; event-driven tasks block on their queues. */
#define APP_MONITOR_PERIOD_MS 100u
#define APP_SENSOR_PERIOD_MS MQ_SCAN_PERIOD_MS
#define APP_MENU_PERIOD_MS KEY_POLL_MS
#define APP_TASK_WAIT_MS 100u
#define APP_RTOS_HEAP_BYTES (11u * 1024u)
#define APP_RTOS_MAX_SYSCALL_PRIORITY 5u
#define APP_FLASH_BUDGET_BYTES (60u * 1024u)
#define APP_RAM_BUDGET_BYTES (20u * 1024u)
#define APP_TASK_COUNT 6u
#define APP_HEARTBEAT_MS 1000u
#define APP_STATUS_MS 5000u
#define APP_RTOS_TICK_HZ 1000u
#define APP_RTOS_MAX_PRIORITIES 6u
#define APP_RTOS_TASK_NAME_LENGTH 16u
#define APP_RTOS_PRIORITY_BITS 4u
#define APP_IDLE_STACK 96u
#define APP_TIMER_STACK 192u
#define APP_TIMER_PRIORITY 3u
#define APP_TIMER_QUEUE 6u
#define APP_KEY_QUEUE 8u
#define APP_KEY_DEBOUNCE_MS 30u
#define APP_RGB_STEP_MS 200u
#define APP_UART_TIMEOUT_MS 20u
#define APP_LOG_LOCK_MS 50u
#define APP_NET_LINE_SIZE 128u
#define APP_NET_TX_SIZE 256u
#define APP_NET_POLL_MS 10u
#define APP_NET_RING_GUARD_MS 30u
#define APP_NET_DIAGNOSTIC_MS 5000u
#define APP_OLED_WIDTH 128u
#define APP_OLED_HEIGHT 64u
#define APP_OLED_PAGES 8u
#define APP_OLED_FRAME_MS 80u
#define APP_OLED_RETRY_MS 500u
#define APP_OLED_TIMEOUT_MS 8u
#define APP_OLED_CHUNK 32u
#define APP_EC11_RING_SIZE 64u
#define APP_EC11_EDGES_PER_DETENT 4
#define APP_MENU_STACK_DEPTH 3u
#define APP_MENU_ROWS 5u
#define APP_EDIT_ACCEL 10
#define APP_EDIT_ACCEL_MS 3000u
#define APP_EDIT_MAX_TEMP 100
#define APP_EDIT_MAX_DISTANCE 500
#define APP_EDIT_MAX_CONFIRM_MS 60000
#define APP_UI_ROWS_Y 16
#define APP_UI_ROW_HEIGHT 8
#define APP_UI_STATUS_X 66
#define APP_UI_STATUS_STEP 12
#define APP_STARTUP_LIMIT_MS 15000u
#define APP_NET_TEST_MS 2000u
#define APP_NET_TEST_LINE "sms-hub loopback\r\n"
#define APP_LSE_TIMEOUT_MS 5000u
#define APP_LSI_TIMEOUT_MS 100u
#define APP_RTC_TIMEOUT_MS 100u
#define APP_I2C_TIMEOUT_MS 3u
#define APP_I2C_FIRST_ADDR 8u
#define APP_I2C_LAST_ADDR 119u
#define APP_I2C_RECOVERY_CLOCKS 9u
#define APP_I2C_PULSE_US 5u
#define APP_PANIC_UART_SPINS 100000u
#define APP_TEMP_FAULT_VALUE (-32768)
#define APP_WATCHDOG_STARTUP_MS 1500u
#define APP_ADC_DMA_SAMPLES (ADC_CHANNEL_COUNT * ADC_SAMPLES_PER_CH * 2u)
#define APP_RTC_BACKUP_MAGIC 0x534Du
#define APP_STACK_MIN_PERCENT 30u
#define APP_WATCHDOG_TEST_ENABLED 0
#define APP_WATCHDOG_TEST_NONE 0xffffffffu
#define APP_NET_TX_TIMEOUT_MS 100u
#define APP_ADC_PUBLISH_MS 10u
#define APP_SENSOR_POLL_MS 50u
#define APP_SENSOR_TABLE_MS 5000u
#define APP_SENSOR_REGULAR_MS 200u
#define APP_SENSOR_STALE_MULTIPLIER 3u
#define APP_DATAHUB_LOCK_MS 5u
#define APP_FILTER_WINDOW 5u
/* Enable only AFTER confirming the translated DO wiring in Docs/M8-wiring.md. */
#define APP_MQ_DO_ENABLED 1
#define APP_SENSOR_UNKNOWN (-1)
#define APP_RADAR_SETTLE_MS 1000u
#define APP_MCU_STALE_MS 1000u
#define APP_SPI_LOCK_MS 100u
#define APP_FLASH_SPI_TIMEOUT_MS 10u
#define APP_FLASH_PROGRAM_MS 20u
#define APP_FLASH_ERASE_MS 600u
#define APP_FLASH_BOOT_BUSY_MS 800u
#define APP_FLASH_POLL_MS 2u
#define APP_FLASH_VERIFY_CHUNK 32u
#define APP_STORAGE_QUEUE 4u
#if APP_CRITICAL_AUDIT
/* Diagnostic image only: free RAM for timings; network event ring stays 20. */
#define APP_STORAGE_RECENT 4u
#else
#define APP_STORAGE_RECENT 20u
#endif
#define APP_STORAGE_LOCK_MS 10u
#define APP_CONFIG_MAGIC 0x534D5343u
#define APP_CONFIG_VERSION 1u
#define APP_RECORD_COMMIT 0x434F4D54u
#define APP_EVENT_MAGIC 0x534D5345u
#define APP_CFG_SSID 33u
#define APP_CFG_PASSWORD 65u
#define APP_CFG_HOST 65u
#define APP_CFG_USER 33u
#define APP_CFG_DEVICE 33u
#define APP_CFG_RESERVED (KV_RECORD_SIZE - 13u*4u - APP_CFG_SSID - 2u*APP_CFG_PASSWORD - APP_CFG_HOST - APP_CFG_USER - APP_CFG_DEVICE - 8u)
#define APP_MQTT_USER ""
#define APP_MQTT_PASSWORD ""
#ifndef APP_DEVICE_DEFAULT
#define APP_DEVICE_DEFAULT "sms-hub"
#endif
#define APP_MODE_DEFAULT 0u
#define APP_MQTT_KEEPALIVE 60u
#define APP_CONFIG_MAX_PERIOD_MS 3600000u
#define APP_STORAGE_STRESS_ENABLED 0
#define APP_STORAGE_STRESS_WRITES 500u
#define APP_STORAGE_EVENT_STRESS 2304u
#define APP_ACTUATOR_POLL_MS 10u
#ifndef APP_M5_STRESS_ENABLED
#define APP_M5_STRESS_ENABLED 0
#endif
#define APP_M5_STRESS_CYCLES 100u
#define APP_SELF_TEST_MS 15000u
#define APP_ALARM_HOT_CONFIRM_MS 1000u
#ifndef APP_M7_TEST_ENABLED
#define APP_M7_TEST_ENABLED 0
#endif
#ifndef APP_M8_TEST_ENABLED
#define APP_M8_TEST_ENABLED 0
#endif
#define APP_BURN_REPORT_MS 60000u
#endif
