lhn-hub/stm32-smart-environment-monitor/Drivers_Device/dht11/dht11.c

#include "dht11.h"
#include "app_config.h"
#include "bsp_timer_us.h"
#include "sensor_filter.h"
#include "FreeRTOS.h"
#include "task.h"
static volatile uint16_t widths[DHT11_CAPTURE_WIDTHS];
static volatile uint32_t last_edge;
static volatile unsigned captured;
static volatile uint8_t active,seen_low,level,error;
static sensor_filter_t temperature_filter,humidity_filter;
static dht11_debug_t debug_info;
static volatile uint32_t edge_gap;
static volatile uint32_t capture_irqs;
static uint8_t low_level,released_level,end_level;
static dht11_error_t decode_error;
static unsigned decode_index,decode_width;

static int decode_bad(dht11_error_t why,unsigned index,unsigned width_us)
{ decode_error=why;decode_index=index;decode_width=width_us;return -1; }
static int read_bad(dht11_error_t why,uint32_t start_ms,uint32_t capture_us)
{
    debug_info.last_error=why;++debug_info.errors[why];
    debug_info.start_ms=start_ms;debug_info.capture_us=capture_us;
    debug_info.captured_widths=captured;
    debug_info.bad_index=why==DHT_ERR_EDGE_GAP?captured:decode_index;
    debug_info.bad_width_us=why==DHT_ERR_EDGE_GAP?edge_gap:decode_width;
    debug_info.irqs=capture_irqs;debug_info.low_level=low_level;
    debug_info.released_level=released_level;debug_info.end_level=end_level;
    temperature_filter.count=humidity_filter.count=0;
    temperature_filter.next=humidity_filter.next=0;
    return -1;
}
const dht11_debug_t *dht11_debug(void){return &debug_info;}

int dht11_decode(const uint16_t *w,size_t n,int32_t *t,int32_t *h)
{
    uint8_t bytes[5]={0};unsigned i;
    decode_error=DHT_ERR_NONE;decode_index=decode_width=0;
    if(!w || !t || !h || n!=DHT11_CAPTURE_WIDTHS)return decode_bad(DHT_ERR_INCOMPLETE,0,0);
    for(i=0;i<2;i++)if(w[i]<DHT11_RESPONSE_MIN_US || w[i]>DHT11_RESPONSE_MAX_US)return decode_bad(DHT_ERR_RESPONSE_WIDTH,i,w[i]);
    for(i=0;i<40;i++){
        uint16_t low=w[2u+i*2u],high=w[3u+i*2u];unsigned bit;
        if(low<DHT11_BIT_LOW_MIN_US || low>DHT11_BIT_LOW_MAX_US)return decode_bad(DHT_ERR_BIT_WIDTH,2u+i*2u,low);
        if(high>=DHT11_ZERO_MIN_US && high<=DHT11_ZERO_MAX_US)bit=0;
        else if(high>=DHT11_ONE_MIN_US && high<=DHT11_ONE_MAX_US)bit=1;
        else return decode_bad(DHT_ERR_BIT_WIDTH,3u+i*2u,high);
        bytes[i/8u]=(uint8_t)((bytes[i/8u]<<1)|bit);
    }
    if((uint8_t)(bytes[0]+bytes[1]+bytes[2]+bytes[3])!=bytes[4])return decode_bad(DHT_ERR_CHECKSUM,0,0);
    if(bytes[1]>9u || (bytes[3]&0x7fu)>9u)return decode_bad(DHT_ERR_RANGE,0,0);
    *h=(int32_t)bytes[0]*10+bytes[1];
    *t=(int32_t)bytes[2]*10+(bytes[3]&0x7fu);
    if(bytes[3]&0x80u)*t=-*t;
    if(*h>DHT11_HUM_MAX_X10 || *t<DHT11_TEMP_MIN_X10 || *t>DHT11_TEMP_MAX_X10)return decode_bad(DHT_ERR_RANGE,0,0);
    return 0;
}
static void input_mode(void)
{
    GPIO_InitTypeDef g={0};g.Pin=DHT11_PIN;g.Mode=GPIO_MODE_INPUT;g.Pull=GPIO_PULLUP;
    /* F1 HAL_GPIO_Init(INPUT) does not disable an already configured EXTI. */
    EXTI->IMR&=~DHT11_PIN;__HAL_GPIO_EXTI_CLEAR_IT(DHT11_PIN);
    HAL_GPIO_Init(DHT11_PORT,&g);
}
int dht11_init(sensor_id_t id)
{
    GPIO_InitTypeDef g={0};g.Pin=DHT11_PIN;g.Mode=GPIO_MODE_IT_RISING_FALLING;g.Pull=GPIO_PULLUP;
    (void)id;active=0;temperature_filter.count=humidity_filter.count=0;temperature_filter.next=humidity_filter.next=0;
    HAL_GPIO_Init(DHT11_PORT,&g);input_mode();return 0;
}
void dht11_edge_irq(void)
{
    uint8_t next;uint32_t now,dt;
    if(!active)return;
    ++capture_irqs;
    next=(DHT11_PORT->IDR&DHT11_PIN)?1u:0u;now=bsp_micros();
    if(!seen_low){if(!next){seen_low=1;level=0;last_edge=now;}return;}
    if(next==level)return;
    dt=now-last_edge;level=next;last_edge=now;
    if(dt>DHT11_EDGE_MAX_US || captured>=DHT11_CAPTURE_WIDTHS){edge_gap=dt;error=1;active=0;return;}
    widths[captured++]=(uint16_t)dt;
    if(captured==DHT11_CAPTURE_WIDTHS)active=0;
}
int dht11_read(sensor_id_t id,sensor_value_t *out)
{
    GPIO_InitTypeDef g={0};uint32_t start,start_ms,capture_us;int32_t t,h;
    (void)id;
    if(!out || HAL_GetTick()<DHT11_POWERUP_MS)return -1;
    /* PB12 replaces unused EC11 EXTI12. Never mask full3~5ms response:
     * TIM4 priority4 remains active; short setup critical section only.
     * No delay/print/flash in critical section or ISR. */
    active=0;captured=0;capture_irqs=0;decode_index=decode_width=0;
    low_level=released_level=end_level=2u;
    HAL_GPIO_WritePin(DHT11_PORT,DHT11_PIN,GPIO_PIN_RESET);
    g.Pin=DHT11_PIN;g.Mode=GPIO_MODE_OUTPUT_OD;g.Speed=GPIO_SPEED_FREQ_LOW;g.Pull=GPIO_PULLUP;
    HAL_GPIO_Init(DHT11_PORT,&g);start=HAL_GetTick();
    vTaskDelay(pdMS_TO_TICKS(DHT11_START_LOW_MS)+1u);
    start_ms=HAL_GetTick()-start;
    low_level=(uint8_t)HAL_GPIO_ReadPin(DHT11_PORT,DHT11_PIN);
    if(start_ms>DHT11_START_MAX_MS){input_mode();return read_bad(DHT_ERR_START_LONG,start_ms,0);}
    taskENTER_CRITICAL();
    captured=0;edge_gap=0;error=seen_low=0;active=1;
    /* Arm EXTI before releasing open-drain: the response can begin in 10us. */
    __HAL_GPIO_EXTI_CLEAR_IT(DHT11_PIN);
    EXTI->IMR|=DHT11_PIN;
    start=bsp_micros();
    HAL_GPIO_WritePin(DHT11_PORT,DHT11_PIN,GPIO_PIN_SET);
    released_level=(uint8_t)HAL_GPIO_ReadPin(DHT11_PORT,DHT11_PIN);
    taskEXIT_CRITICAL();
    while(active && (uint32_t)(bsp_micros()-start)<DHT11_CAPTURE_TIMEOUT_US)vTaskDelay(1);
    taskENTER_CRITICAL();active=0;taskEXIT_CRITICAL();
    capture_us=bsp_micros()-start;
    end_level=(uint8_t)HAL_GPIO_ReadPin(DHT11_PORT,DHT11_PIN);
    input_mode();
    if(error)return read_bad(DHT_ERR_EDGE_GAP,start_ms,capture_us);
    if(!seen_low)return read_bad(DHT_ERR_NO_RESPONSE,start_ms,capture_us);
    if(dht11_decode((const uint16_t *)widths,captured,&t,&h))return read_bad(decode_error,start_ms,capture_us);
    out->value=sensor_mean(&temperature_filter,t);out->auxiliary=sensor_mean(&humidity_filter,h);
    out->quality=out->auxiliary_quality=SENSOR_GOOD;out->timestamp=HAL_GetTick();return 0;
}
