lhn-hub/stm32-smart-environment-monitor/BSP/bsp_services.h

#ifndef BSP_SERVICES_H
#define BSP_SERVICES_H
#include <stdint.h>
#include <stddef.h>
/** @brief Initialize runtime BSP services before the scheduler; return 0 on success. */
int bsp_services_init(void);
/** @brief Immediately stop actuators without allocation or blocking. */
void bsp_safe_state(void);
/** @brief Latch a fault and reject future actuator requests until reset. */
void bsp_emergency_stop(void);
int bsp_is_faulted(void);
/** @brief Bounded emergency output then safe halt; callable from fault hooks. */
void bsp_panic(const char *reason);
void bsp_fault_dump(const uint32_t *frame,uint32_t exception_return);
void bsp_fault_record(unsigned cause,uint32_t pc);
void bsp_boot_stats(unsigned *watchdogs,unsigned *boots);
void bsp_backup_restore(void);
void bsp_fault_hex(const char *label,uint32_t value);
void bsp_audit_report(void);
void bsp_audit_start(void);
/** @brief Task-only serialized printf log. No floating point formats. */
void bsp_log(const char *level, const char *format, ...);
/** @brief Task-only bounded logging exclusion for one short polling transfer.
 * @return 0 with existing priority-inheritance console mutex held, -1 otherwise.
 * @note No interrupt masking or scheduler suspension. Never log while held;
 * call end on every exit. This is not an I2C bus ownership lock.
 */
int bsp_log_quiet_begin(uint32_t timeout_ms);
void bsp_log_quiet_end(void);
#define LOGI(...) bsp_log("信息", __VA_ARGS__)
#define LOGW(...) bsp_log("警告", __VA_ARGS__)
#define LOGE(...) bsp_log("错误", __VA_ARGS__)
/** @brief Set RGB PWM duties; reject values outside 0..999. */
int rgb_set(uint16_t r, uint16_t g, uint16_t b);
typedef enum {EFFECT_STANDBY,EFFECT_FIRE,EFFECT_INTRUSION,EFFECT_AIR,EFFECT_FAULT,EFFECT_NETWORK,EFFECT_COUNT} effect_t;
/** @brief Nonblocking light primitive, owns outputs until replaced. */
int effect_set(effect_t effect);
typedef enum { KEY_WAKEUP, KEY_BACK, KEY_CONFIRM } key_source_t;
typedef enum { KEY_CLICK, KEY_LONG } key_action_t;
typedef struct { key_source_t source; key_action_t action; uint32_t tick; } key_event_t;
/** @brief Receive a debounced key event without blocking. */
int bsp_key_get(key_event_t *event);
/** @brief Return 0 with temperature x10, or -1 while quality is FAULT. */
int mcu_temp_get(int32_t *temperature_x10);
/** @brief Return estimated VDDA mV; 0 means no valid ADC sample. */
uint32_t vdda_mv_get(void);
/** @brief Atomically copy ADC estimate and last DMA sample time (task context). */
void bsp_adc_snapshot(uint32_t *millivolts,uint32_t *timestamp);
/** @brief Read/write UTC Unix seconds; SensorTask owns writes via app_time. */
uint32_t rtc_get(void);
int rtc_set(uint32_t seconds);
/** @brief Owner-task-only recovery: SensorTask during startup, MenuTask after handoff; never concurrent. */
int bsp_i2c_recover(void);
/** @brief Scan legal 7-bit addresses and print results in task context. */
void i2c_scan(void);
/** @brief Drain DMA ring in NetTask, splitting complete newline-terminated lines. */
void bsp_net_poll(void);
/** @brief Override in App; called in NetTask, buffer valid only during callback. */
void net_on_rx_line(const char *line, size_t length);
/** @brief Override in App; called for binary bytes after an ESP `+IPD` header. */
void net_on_rx_bytes(const uint8_t *data, size_t length);
/** @brief Override in App; called when ESP enters `CIPSEND` data mode. */
void net_on_rx_prompt(void);
/** @brief Copy into an owned TX buffer and start DMA; return -1 if busy/invalid. */
int bsp_net_send(const void *data, size_t length);
/** @brief Borrow the owned DMA TX buffer for one formatted command. */
char *bsp_net_tx_buffer(size_t *capacity);
/** @brief Start DMA using the buffer returned by bsp_net_tx_buffer(). */
int bsp_net_send_buffer(size_t length);
/** @brief Reset ESP8266 with PB9 low for 100ms, then restart RX DMA. */
int bsp_net_hard_reset(void);
/** @brief USART3 IRQ pre-handler; acknowledges IDLE, never parses or prints. */
void bsp_net_idle_irq(void);
void bsp_console_poll(void);
void bsp_console_rx_irq(void);
void bsp_console_release(void);
void bsp_console_line(const char *text,size_t length);
int bsp_console_wifi_text(char *ssid,char *password);
/** @brief Start IWDG / refresh after Monitor has checked all heartbeats. */
int bsp_watchdog_start(void);
void bsp_watchdog_feed(void);
/** @brief Start six FreeRTOS tasks; does not return on success. */
void app_start(void);
#endif
