lhn-hub/stm32-smart-environment-monitor/(commit log)

2026-10-04 [M0] 工程:建立脚手架并通过静态与编译核查
2026-10-04 [M1] BSP:集成FreeRTOS六任务与板级服务
2026-10-04 [M1] BSP:修正RGB低有效极性并中文化串口日志
2026-10-04 [M1] 串口:恢复接收后汇总错误避免警告刷屏
2026-10-04 [M1] 验收:记录用户确认并发布v0.2
2026-10-04 [M2] 显示:实现OLED编码器与三级菜单
2026-10-05 [M2] 显示:改善点阵字模并增加编码器边沿诊断
2026-10-05 [M2] 菜单:取消EC11改用PA0三键交互
2026-10-05 [M2] 验收:记录三键菜单功能确认
2026-10-05 [M3] 配置:采用资料默认值替代标定回填
2026-10-05 [M3] 传感器:集成统一驱动滤波与DataHub快照
2026-10-05 [M3] 诊断:区分传感器时序失败与OLED传输错误
2026-10-05 [M3] 修复:延后DHT首读并隔离OLED发送与同步日志
2026-10-06 [M3] 超声波:修正PA15触发与PB3回波中断映射
2026-10-06 [M4] 存储:实现Flash仲裁双副本配置与环形事件日志
2026-10-07 [M4] 诊断:拆分Flash初始化失败阶段
2026-10-12 [M5] 完成执行器联动与验收修复
2026-10-13 [M6] 实现现有ESP固件TCP-MQTT并验证上线遥测
2026-10-13 [M7] 集成报警状态机与配置闭环并提供验收钩子
2026-10-13 [M8] 添加云看板与故障诊断及烤机验收
2026-10-14 Publish STM32 smart environment monitor project
